leanofis-iot/lora/outdoor-4200/README.txt

SWAP DIGITAL PINNS 3,2 TO 0,1
USE PULLUPS FOR SCL,SDA
DIGITAL PINS TO MOST RIGHT OF CONNECTOR
EDIT ATTACHINTERRUPT
----------------------------------------------------------------------------
HWB 10K GND
CONF CALIBRATE
2MM FULL JUMPER RESISTOR

---------------------------
CONNECTORS
C1,2,3,4,5,6,8
XT1
R2,3,4
LED1
SW1

LoRaWAN Class A/C, EU868MHz
Periodical and Alarm Uplink 
Full Configuration via USB / downlink
Over The Air Activation OTAA
Plug & Play The Things Network, Cayenne

2 Channel Analog Inputs
2 Single / 2 Differential, 0-5V / 0-10V / 4-20ma 
2 Channel Digital Inputs
Logic / Dry Contact / Pulse Counter
Over Voltage, ESD Protection

3.6V Battery, C size,  9Ah, up to 10 years
Managable Power Output 3.3V / 5V 
External Power Input
