leanofis-iot/lora/outdoor-811/Sensör Kullanımı.docx

!!! GATEWAY, ELEKTRİĞE BAĞLAMADAN ÖNCE

ANTENİ TAKILMIŞ OLMALIDIR.

Gateway’e Ehernet Kablosu Bağla

Gateway elektriğe bağla

2 dakika kadar bekle, PWR ve LoRa ledleri sabit yanıyor olacak

Gateway, internete ve TTN’e bağlandı.

Web’de Cayenne konsolu’na git

https://cayenne.mydevices.com/cayenne/dashboard/lora

email: leanofis.iot@gmail.com

password: lean1234

Yukarıda leanofis tıkla

Projedeki tüm cihazlar görüntüleniyor

Sol taraftaki listeden cihazlar ayrı ayrı da görülebilir

th3 cihazına pil tak

Yaylı taraf (-) kutup (ters yerleştirme koruması var)

pil takıldığında ilk göndermeyi yapar

Not:

1. th3 cihaz içindeki mevcut ayarlar;

Gönderme periyodu: 30dk

Sıcaklık düşük alarmı: 10 C

Sıcaklık yüksek alarmı: 40 C

Nem düşük alarmı: 35%

Nem yüksek alarmı: 65%

2. Telefon uygulaması da indirilebilir

Cayenne (myDevices)
