leanofis-iot/lora/outdoor-4200/eagle/ad/BOM.xlsx

IC1 | 1 | ATMEGA32U4-MU | QFN-44
IC2 | 1 | MIC5219YML | TQFN-6
MOD1 | 1 | RAK4200 (H) LORA MODULE | SM-20
Q1,2,3 | 3 | SI2301BDS | SOT23-3
D1,2 | 2 | B5817W (MBR120) | SOD123
D3 | 1 | BZT52C3V9 | SOD123
LED1 | 1 | LED RED | 0805
XT1 | 1 | CRYSTAL PASSIVE 8MHZ 4PIN | 5032
F1 | 1 | PTC RESETTABLE FUSE 0.5A | 1206
SW1 | 1 | PUSH BUTTON 5.2X5.2MM 4P | SM
SW2 | 1 | REED SWITCH <10MM NO | DIP
BAT1 | 1 | 211P-C PCB PIN C SIZE BATTERY HOLDER | DIP
CON1 | 1 | HEADER MALE 2.54MM 6P 2R | DIP
CON2 | 1 | HEADER MALE 2.54MM 10P 2R | DIP
CON3 | 1 | CONNECTOR RF SMA R/A EOCT-WF1320 57001579 | DIP
CON4 | 1 | USB3131 MICRO B USB VERTICAL FEMALE | DIP
CON5 | 1 | HEADER FEMALE 2.54MM 6P 1R | DIP
J1 | 1 | HEADER MALE 2.54MM 2P 1R | DIP
C1,9,13,16 | 4 | 4.7UF | 0603
C2,5,7,8,10,11,12,17,21,22 | 10 | 100NF | 0603
C3,4 | 2 | 22PF | 0603
C6 | 1 | 1UF | 0603
C14,15 | 2 | 10UF | 0805
C18 | 1 | 470PF | 0603
C19,20 | 2 | 1F 2.7V FARAD CAPACITOR 8MM | DIP
R1,3,4,6,8,9,11,13,15,22,23,24,25 | 12 | 10K | 0603
R2,16 | 2 | 1K | 0603
R5,7,10,14 | 3 | 100R | 0603
R12,17 | 2 | 2.2K | 0603
R18,19 | 2 | 22R | 0603
R20
R21
PCB |  | FR4 1.6MM 68x62MM
BATTERY 3.6V 9000MAH C SIZE LISCLO2 |  | ER26500
ANTENNA |  | 868MHZ 8CM SMA-MALE B INNO-868-ZT8BM 57001549
ENCLOSURE IP65 76X70X40MM |  | H-393
SENSOR SHELL/COVER PLASTIC |  | TEMPERATURE & HUMIDITY
