leanofis-iot/lora/outdoor-811/eagle/ad/BOM.xlsx

IC1 | ATMEGA32U4-MU | QFN-44
IC2 | S-5712BNDL2-M3T1U | SOT23-3
IC3 | MIC5219-3.3YML | VQFN-6
IC4 | MCP1640-I/MC | DFN-8
IC5 | ADS1118IRUG | X2QFN-10
IC6 | VREF | SOT23-3
MOD1 | RAK811 | SM-34
Q1,2,3,4 | SI2301 P MOSFET | SOT23-3
D1,2,3 | B5817W | SOD123 | MBR120
D4 | BZT52C3V9 | SOD123
D5,6,7,8,9,10 | BAT54S | SOT23-3
LED1 | LED RED | 0805
XT1 | CRYSTAL PASSIVE 8MHZ 4PIN | 5032
F1 | RESETTABLE FUSE 0.5A | 1206
SW1 | PUSH BUTTON 5X5MM | SM
J1,2,5,6 | HEADER 2.54MM 3P | DIP
J3,4 | HEADER 2.54MM 2P | DIP
ANT1 | CONNECTOR RF SMA R/A EOCT-WF1320 57001579 | DIP
ANT1 | ANTENNA 868MHZ 8CM SMA-MALE B INNO-868-ZT8BM 57001549
CON1 | HEADER 2.54MM 6P 2R | DIP
CON2 | HEADER 2.54MM 10P 2R | DIP
CON3 | CONNECTOR 12P 2.54MM 141V | DIP
CON4 | USB3131 MICRO B USB VERTICAL FEMALE | DIP
L1 | INDUCTOR 4.7UH | 0630
C1,9,13,16,21,30 | 4.7UF | 0603 | C30 ??
C2,5,7,8,10,11,12,17,22,23,25,26,28,29 | 100NF | 0603
C3,4 | 22PF | 0603
C6,24,27 | 1UF | 0603
C14,15,19,20 | 10UF | 0805
C18 | 470PF | 0603
R1,24 | NC | 0603
R2,4,6,8,9,11,27,53 | 10K | 0603
R3,29,30,31 | 1K | 0603
R5,7,14,25,28 | 100R | 0603
R10 | 0R | 0603
R12,17 | 68K | 0603
R13,23 | 100K | 0603
R15,26,45,49,52 | 2.2M | 0603
R16,22 | 27K | 0603
R18,19 | 22R | 0603
R20 | 47K | 0603
R21 | 15K | 0603
R32,38 | 2.2K | 0805
R34,36,40,42 | 2.2M | 0805
R37,43 | 500R | 0805
R33,35,39,41,46,47,50,51 | 10K | 0805
R44,48 | 1K | 0805
PCB
BATTERY
BATTERY HOLDER C SIZE | BH-211-1A
CHINA BATTERY HOLDER
BOX
CABLE GLAND
TH SHELL
