leanofis-iot/lora/rtu/arduino/rtu past3/eagle/BOM.xlsx

IC1 | 1 | ATMEGA32U4-MU | QFN-44
IC2 | 1 | AP63200WU-7 | SOT23-6
IC3 | 1 | DS3231M | SOIC-8 | link (http://www.aliexpress.com/item/32842116667.html?spm=a2g0o.productlist.0.0.207e5425iMi2qF)
IC4,5 | 2 | HCPL-181-00BE (PC357N) | SM MINI FLAT | link (https://www.aliexpress.com/item/32909119073.html?spm=2114.12010615.8148356.4.657bf361XrP6RL)
IC6,7 | 2 | INA226AIDGS | VSSOP-10 | link (http://www.aliexpress.com/item/33021667752.html?spm=2114.12010615.8148356.2.31ef2adf4GEmzi)
IC8 | 1 | ISL3172EIBZ | SOIC-8 | link (https://www.aliexpress.com/item/4000185507133.html?spm=2114.12010615.8148356.1.508c33460t39pk)
IC9,10 | 2 | NUD3124DMT1G | SC74-6 | link (https://www.aliexpress.com/item/32968598412.html?spm=2114.12010615.8148356.1.2f9a547akpF4q6)
MOD1 | 1 | RAK4200 LORA MODULE EU868MHZ | SM-20 | link (https://store.rakwireless.com/products/rak4200-lora-module?variant=31767678091309)
D1,2 | 2 | B5817W | SOD123 | REFERENCE
D3 | 1 | BZT52C3V9 | SOD123 | REFERENCE
LED1 | 1 | LED LAMP HOLDER BLOCK RED GREEN | DIP | link (https://www.aliexpress.com/item/32599385323.html)
XT1 | 1 | CRYSTAL PASSIVE 8MHZ 4PIN | 5032 | link (https://www.aliexpress.com/item/33010692278.html?spm=2114.12010615.8148356.8.e30c5802x90R2k)
F1 | 1 | PTC RESETTABLE FUSE 0.5A | 1206 | link (https://www.aliexpress.com/item/32876140005.html?spm=2114.12010615.8148356.3.5236158aukLNWK)
F2,3 | 2 | PTC RESETTABLE FUSE 0.05A | 1206 | link (https://www.aliexpress.com/item/32876140005.html?spm=2114.12010615.8148356.3.5236158aukLNWK)
SW1,2 | 2 | PUSH BUTTON TACTILE SWITCH 6X6X9MM R/A | DIP | link (https://www.aliexpress.com/item/32901481925.html)
SW3,4 | 2 | HFD2-003-M-L2 3VDC BISTABLE/LATCH 2 COIL RELAY | DIP | link (https://www.aliexpress.com/item/4000554934263.html?spm=2114.12010615.8148356.4.712c6ca21gaZmO)
BAT1 | 1 | CR1220 BATTERY HOLDER INSERT 15MM ( BS-1220 ) (BC501SM) (S8411-45R) | SM | link (https://www.aliexpress.com/item/32971589644.html?spm=2114.12010615.8148356.6.6289344daPmFSS)
(BATTERY) | 1 | CR1220 3V LITHIUM COIN | COIN
CON1 | 1 | HEADER MALE 2.54MM 6P 2R | DIP
CON2 | 1 | HEADER MALE 2.54MM 8P 2R | DIP
CON3 | 1 | CONNECTOR RF SMA R/A EOCT-WF1320 57001579 | DIP | link (https://www.aliexpress.com/item/33050835786.html)
CON4 | 1 | STANDARD MICRO B USB FEMALE CONNECTOR | SM | link (https://www.aliexpress.com/item/32847817922.html)
CON5 | 1 | KF2EDGR-3.5-12P (HEADER) + KF2EDGK-3.5-12P (PLUG) | DIP
CON6 | 1 | KF2EDGR-3.5-6P (HEADER) + KF2EDGK-3.5-12P (PLUG) | DIP
L1 | 1 | CDRH74R 6.8UH INDUCTOR 7.3X7.3X4MM SHIELDED | SM | 0630 SIZE SHIELDED REFERENCE
L2,3 | 2 | MMZ2012Y152B FERRITE BEAD | 0805 | (150R @100MHZ) REFERENCE
C1,9,16,19,24,27,30 | 7 | 4.7UF X5R/X7R | 0603
C2,5,7,8,12,15,17,18,20,21,22,23,25,28,31,33 | 16 | 100NF X5R/X7R | 0603
C3,4 | 2 | 22PF X5R/X7R | 0603
C6,26,29 | 3 | 1UF X5R/X7R | 0603
C10,13,14 | 3 | 22UF X7R | 1206
C11 | 1 | 100PF X5R/X7R | 0603
C32 | 1 | 100UF 8MM | SM
R1,2 | 2 | 22R 5% | 0603
R3,4,10,12,14,18,19,20,22,24,25,30,35,37,40,43 | 16 | 10K 5% | 0603
R5,6 | 2 | 220R 5% | 0603
R7 | 1 | 115K 1% | 0603
R8 | 1 | 33K 1% | 0603
R9,11,13,36,38,39 | 6 | 100R 5% | 0603
R15,16,17 | 3 | 1K 5% | 0603
R21,23 | 2 | 2K2 5% | 0805
R26,28,31,33 | 4 | 10R 1% | 0603
R27,32 | 2 | 3.3R 1% | 1206
R29,34 | 2 | 10R 5% | 0603
R41,42 | 2 | 10R 1% | 0805
ANTENNA | 1 | 868MHZ 5DBI SMA-MALE WHIP |  | link (https://www.aliexpress.com/item/32920533464.html?spm=2114.12010612.8148356.1.39749e87FQTW8I)
ALUMINUM ENCLOSURE | 1 | AK-C-A4 28(H)X66(L)X104(W) MM COLOR BLUE |  | angie@szomk.com.cn
PCB | 1 | FR4 1.6MM 1ozCu 76.2X65.4MM (3000X2575MIL) BLUE MASK
