leanofis-iot/lora/outdoor-811/LoRa Sensor Test.docx

!!! GATEWAY VE SENSÖR CİHAZI

ANTENLERİ TAKILMIŞ OLMALIDIR.

Başlamadan bana mesaj atın lütfen..

Gateway’e Ehernet Kablosu bağlayıp adaptörü elektriğe takın.

2 dakika bekleyin, PWR ve LoRa ledleri sabit yanıyor olacak

Gateway, internete bağlandı.

Telefon Browser’da The Things Network (TTN) konsol adresine gidin.

https://console.thethingsnetwork.org/gateways/eui-60c5a8fffe74d32b/traffic

email: leanofis.iot@gmail.com

password: lean1234

Cihaz Gateway’in yakınında iken Pilini takın

Yaylı taraf (-) kutup (ters yerleştirme koruması var)

Led yanıp sönmelerinin tamamlanmasını bekleyin

Cihaz TTN’e kendiliğinden birkaç deneme yaparak bağlanır ve ilk defa veri gönderir.

(Mavi ok işareti ile başlayan satır gönderim kaydıdır)

İstenen mesafelerde Buton’a basıp bırakarak gönderme testi yapabilirsiniz.

Led sönmeden tekrar basmayın.
