leanofis-iot/lora/rtu/arduino/rtu past3/eagle/rtu.brd

## EAGLE design rtu/arduino/rtu past3/eagle/rtu.brd (2020-01-22)

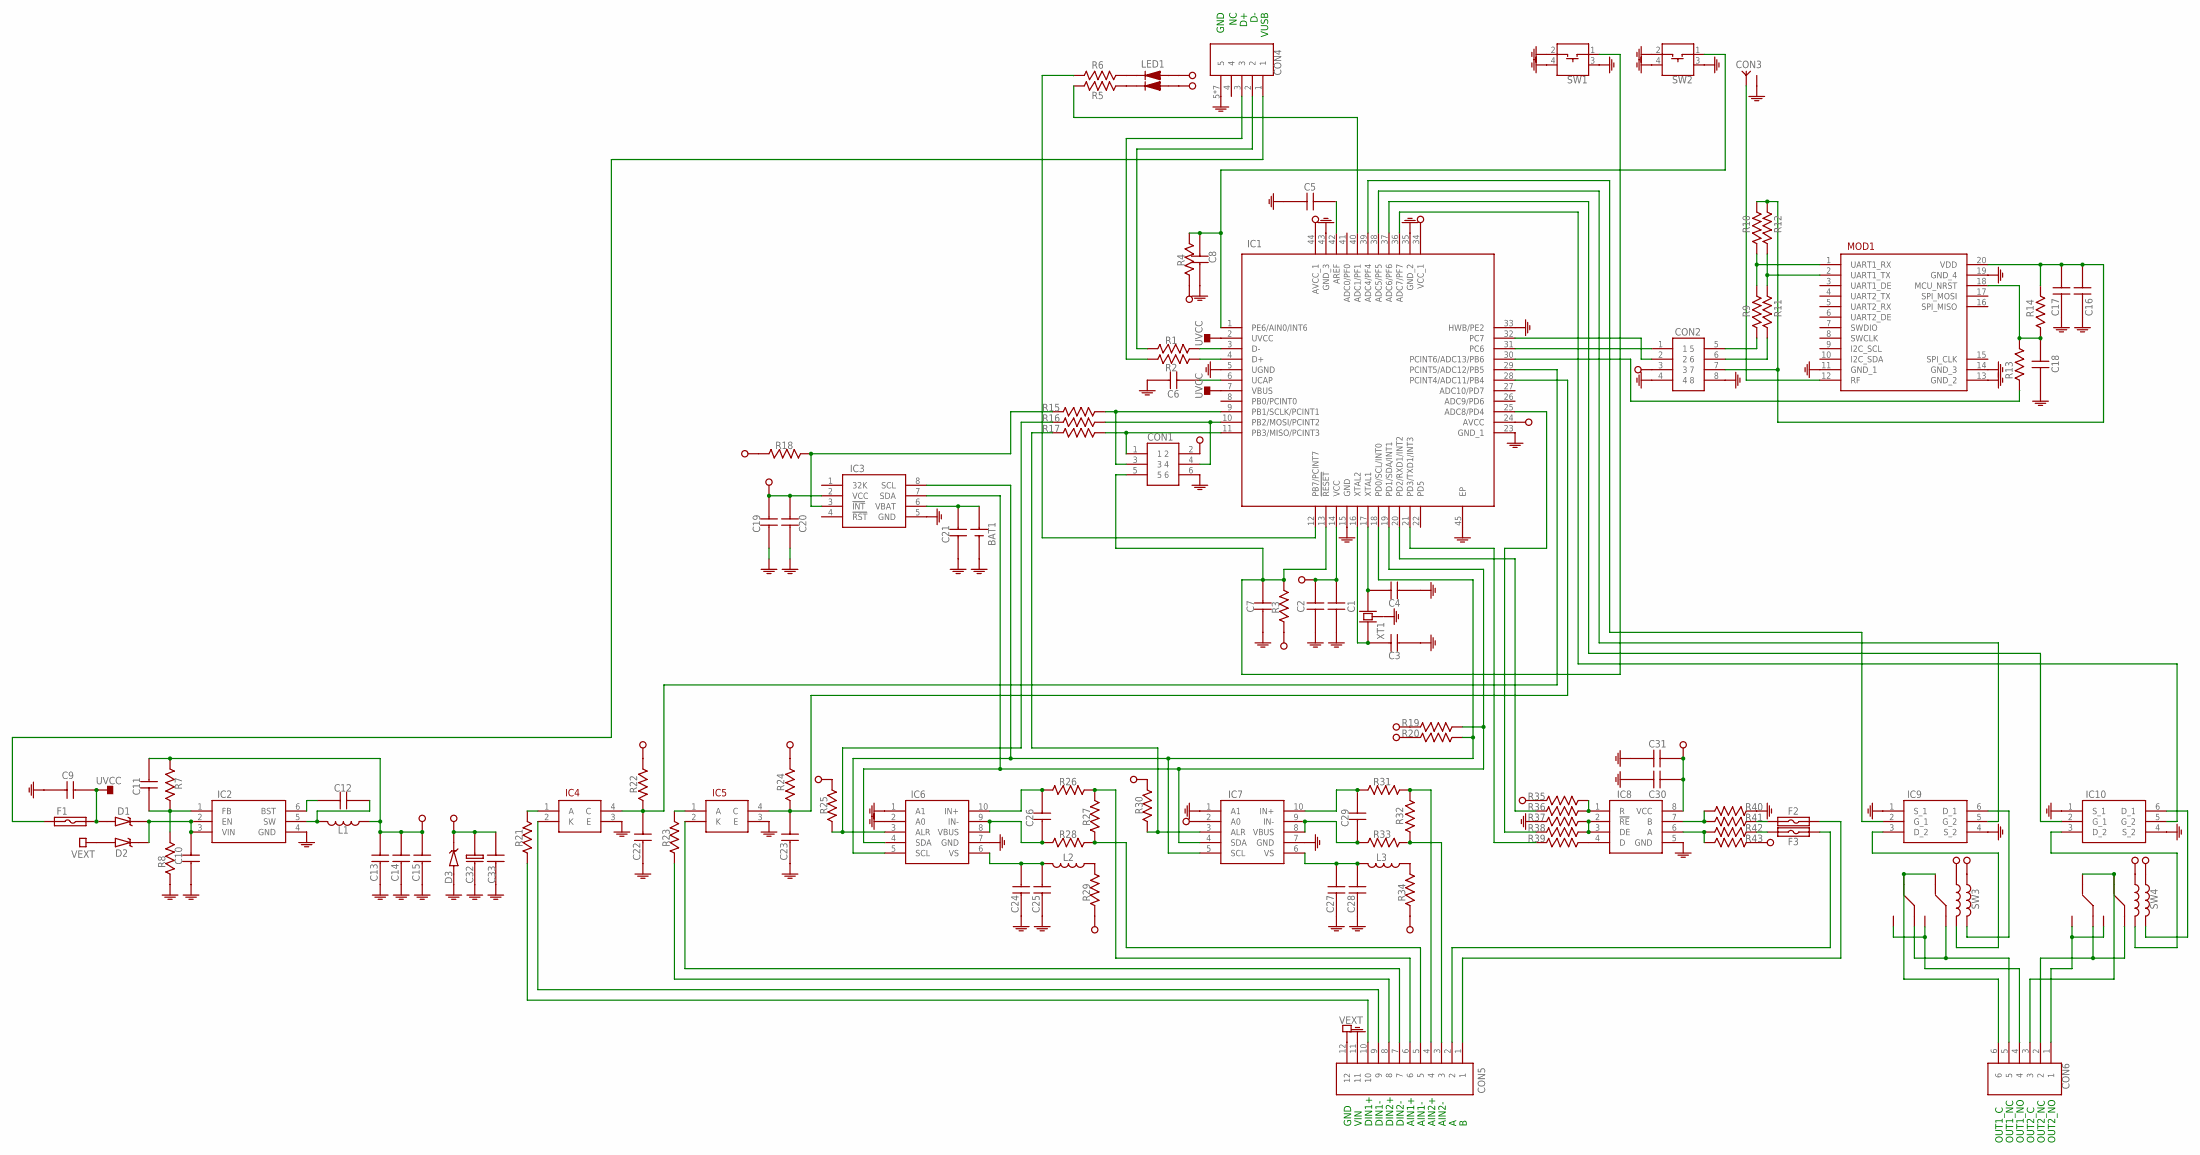
[picture p3: schematic rtu.sch]

Parts:
BAT1: BAT-1220-BC501SM
C1, C2, C3, C4, C5, C6, C7, C8, C9, C11, C12, C15, C16, C17, C18, C19, C20, C21, C22, C23, C24, C25, C26, C27, C28, C29, C30, C31, C33: CAPACITOR-0603; 0603
C10, C13, C14: CAPACITOR-1206; 1206
C32: CAPACITOR-SMD-8
CON1: ISP
CON2: HEADER-8P-2R-DIP-2_54MM
CON3: SMA-RF
CON4: USB-MICRO-B-SMD
CON5: KF2EDGR-3.5-12P
CON6: KF2EDGR-3.5-6P
D1, D2: DIODE-SCHOTTKY; SOD123-DIODE
D3: ZENER-SOD123; SOD123-DIODE
F1, F2, F3: FUSE-1206; 1206
IC1: ATMEGA32U4-MU; QFN-44
IC2: AP63200; SOT23-6
IC3: DS3231M; SOIC-8
IC4, IC5: OPTO-SMD
IC6, IC7: INA226; VSSOP-10
IC8: IC-485-HALF; SOIC-8
IC9, IC10: NUD3105-12-24-60; SC74-6
L1: INDUCTOR-0520-0630
L2, L3: INDUCTOR-0805; 0805
LED1: LED-HOLDER-2P
MOD1: RAK4200
R1, R2, R3, R4, R5, R6, R7, R8, R9, R10, R11, R12, R13, R14, R15, R16, R17, R18, R19, R20, R22, R24, R25, R26, R28, R29, R30, R31, R33, R34, R35, R36, R37, R38, R39, R40, R43: RESISTOR-0603; 0603
R21, R23, R41, R42: RESISTOR-0805; 0805
R27, R32: RESISTOR-1206; 1206
SW1, SW2: B3F-3150-52-55
SW3, SW4: HFD2-L2
XT1: CRYSTAL-5032-4P

Connections:
GND: BAT1.-, C1.1, C2.1, C3.1, C4.1, C5.1, C6.1, C7.1, C8.2, C9.1, C10.1, C13.1, C14.1, C15.1, C16.1, C17.1, C18.1, C19.1, C20.1, C21.1, C22.1, C23.1, C24.1, C25.1, C27.1, C28.1, C30.1, C31.1, C32.1, C33.1, CON1.6, CON2.4, CON2.8, CON3.2 (GND), CON3.3 (GND), CON3.4 (GND), CON3.5 (GND), CON4.5, CON4.6 (5), CON4.7 (5), CON4.8 (5), CON4.9 (5), CON4.10 (5), CON4.11 (5), CON5.11, D3.2 (A), IC1.5 (UGND), IC1.15 (GND), IC1.23 (GND_1), IC1.33 (HWB/PE2), IC1.35 (GND_2), IC1.43 (GND_3), IC1.45 (EP), IC2.4 (GND), IC3.5 (GND), IC4.3 (E), IC5.3 (E), IC6.1 (A1), IC6.2 (A0), IC6.7 (GND), IC7.1 (A1), IC7.7 (GND), IC8.5 (GND), IC9.1 (S_1), IC9.4 (S_2), IC10.1 (S_1), IC10.4 (S_2), MOD1.11 (GND_1), MOD1.13 (GND_2), MOD1.14 (GND_3), MOD1.19 (GND_4), R8.1, R37.1, R40.1, SW1.2, SW1.3, SW1.4, SW2.2, SW2.3, SW2.4, XT1.2 (GND), XT1.4 (GND)
unnamed: IC1.40 (ADC1/PF1), R5.1
unnamed: C18.2, MOD1.18 (MCU_NRST), R13.1, R14.1
unnamed: CON1.1, IC1.11 (PB3/MISO/PCINT3), R17.2
unnamed: CON3.1 (ANT), MOD1.12 (RF)
unnamed: CON2.2, IC1.32 (PC7)
unnamed: MOD1.1 (UART1_RX), R9.2, R10.1
unnamed: MOD1.2 (UART1_TX), R11.2, R12.1
unnamed: LED1.1 (K1), R6.2
unnamed: CON1.4, IC1.10 (PB2/MOSI/PCINT2), R16.2
unnamed: C3.2, IC1.16 (XTAL2), XT1.1
unnamed: CON2.1, IC1.31 (PC6)
unnamed: C4.2, IC1.17 (XTAL1), XT1.3 (2)
unnamed: C16.2, C17.2, CON2.7, MOD1.20 (VDD), R10.2, R12.2, R14.2
unnamed: CON2.5, R9.1
unnamed: LED1.3 (K2), R5.2
unnamed: CON2.6, R11.1
unnamed: C29.1, IC7.8 (VBUS), IC7.9 (IN-), R33.2
unnamed: CON4.2, R1.1
unnamed: CON4.3, R2.1
unnamed: IC4.1 (A), R21.2
unnamed: C29.2, IC7.10 (IN+), R31.2
unnamed: IC1.30 (PCINT6/ADC13/PB6), R13.2
unnamed: IC6.3 (ALR), R16.1, R25.2
unnamed: IC1.36 (ADC7/PF7), IC10.5 (G_2)
unnamed: IC7.3 (ALR), R17.1, R30.2
unnamed: IC9.6 (D_1), SW3.L1-
unnamed: L3.1, R34.2
unnamed: IC9.3 (D_2), SW3.L2-
unnamed: C8.1, IC1.1 (PE6/AIN0/INT6), R4.1, SW2.1
unnamed: CON5.4, R31.1, R32.1
unnamed: C5.2, IC1.42 (AREF)
unnamed: C23.2, IC1.28 (PCINT4/ADC11/PB4), IC5.4 (C), R24.2
unnamed: IC5.1 (A), R23.2
unnamed: C6.2, IC1.6 (UCAP)
unnamed: C22.2, IC1.29 (PCINT5/ADC12/PB5), IC4.4 (C), R22.2
unnamed: IC1.12 (PB7/PCINT7), R6.1
unnamed: IC1.37 (ADC6/PF6), IC10.2 (G_1)
unnamed: CON6.1, SW4.NO1, SW4.NO2
unnamed: CON5.3, R32.2, R33.1
unnamed: C7.2, CON1.5, IC1.13 (!RESET), R3.2, SW1.1
unnamed: C27.2, C28.2, IC7.6 (VS), L3.2
unnamed: IC1.3 (D-), R1.2
unnamed: IC1.4 (D+), R2.2
unnamed: CON1.3, IC1.9 (PB1/SCLK/PCINT1), R15.2
unnamed: CON5.2, F3.1
unnamed: IC8.1 (R), R35.2, R36.2
unnamed: IC8.4 (D), R39.2
unnamed: CON5.7, IC5.2 (K)
unnamed: CON5.9, IC4.2 (K)
unnamed: IC8.7 (B), R40.2, R41.2
unnamed: IC8.6 (A), R42.2, R43.2
unnamed: IC8.2 (!RE), IC8.3 (DE), R37.2, R38.2
unnamed: F3.2, R42.1
unnamed: CON5.8, R23.1
unnamed: CON4.1, F1.1
unnamed: C10.2, D1.1 (K), D2.1 (K), IC2.2 (EN), IC2.3 (VIN)
unnamed: BAT1.+, C21.2, IC3.6 (VBAT)
unnamed: CON5.6, R26.2, R27.2
unnamed: CON5.1, F2.1
unnamed: IC1.20 (PD2/RXD1/INT2), R36.1
unnamed: IC1.21 (PD3/TXD1/INT3), R39.1
unnamed: IC1.25 (ADC8/PD4), R38.1
unnamed: IC10.6 (D_1), SW4.L1-
unnamed: C12.2, IC2.6 (BST)
unnamed: C12.1, IC2.5 (SW), L1.2
unnamed: CON6.2, SW4.NC1, SW4.NC2
unnamed: C26.2, IC6.10 (IN+), R26.1
unnamed: C26.1, IC6.8 (VBUS), IC6.9 (IN-), R28.1
unnamed: IC3.3 (!INT), R15.1, R18.2
unnamed: L2.1, R29.2
unnamed: C11.1, IC2.1 (FB), R7.2, R8.2
unnamed: IC1.18 (PD0/SCL/INT0), IC3.8 (SCL), IC6.5 (SCL), IC7.5 (SCL), R20.2
unnamed: CON6.3, SW4.C1, SW4.C2
unnamed: C24.2, C25.2, IC6.6 (VS), L2.2
unnamed: IC1.19 (PD1/SDA/INT1), IC3.7 (SDA), IC6.4 (SDA), IC7.4 (SDA), R19.2
unnamed: F2.2, R41.1
unnamed: CON5.5, R27.1, R28.2
unnamed: IC10.3 (D_2), SW4.L2-
unnamed: CON5.10, R21.1
unnamed: CON6.4, SW3.NO1, SW3.NO2
unnamed: CON6.5, SW3.NC1, SW3.NC2
unnamed: CON6.6, SW3.C1, SW3.C2
unnamed: IC1.38 (ADC5/PF5), IC9.5 (G_2)
unnamed: IC1.39 (ADC4/PF4), IC9.2 (G_1)
UVCC: C9.2, D1.2 (A), F1.2, IC1.2 (UVCC), IC1.7 (VBUS)
VCC: C1.2, C2.2, C11.2, C13.2, C14.2, C15.2, C19.2, C20.2, C30.2, C31.2, C32.2, C33.2, CON1.2, CON2.3, D3.1 (K), IC1.14 (VCC), IC1.24 (AVCC), IC1.34 (VCC_1), IC1.44 (AVCC_1), IC3.2 (VCC), IC7.2 (A0), IC8.8 (VCC), L1.1, LED1.2 (A1), LED1.4 (A2), R3.1, R4.2, R7.1, R18.1, R19.1, R20.1, R22.1, R24.1, R25.1, R29.1, R30.1, R34.1, R35.1, R43.1, SW3.L1+, SW3.L2+, SW4.L1+, SW4.L2+
VEXT: CON5.12, D2.2 (A)

Notes on the sheet:
VIN
GND
AIN1+
AIN1-
AIN2+
AIN2-
DIN1+
DIN1-
DIN2+
DIN2-
OUT1_C
OUT1_NC
OUT1_NO
OUT2_NC
OUT2_C
OUT2_NO
VUSB

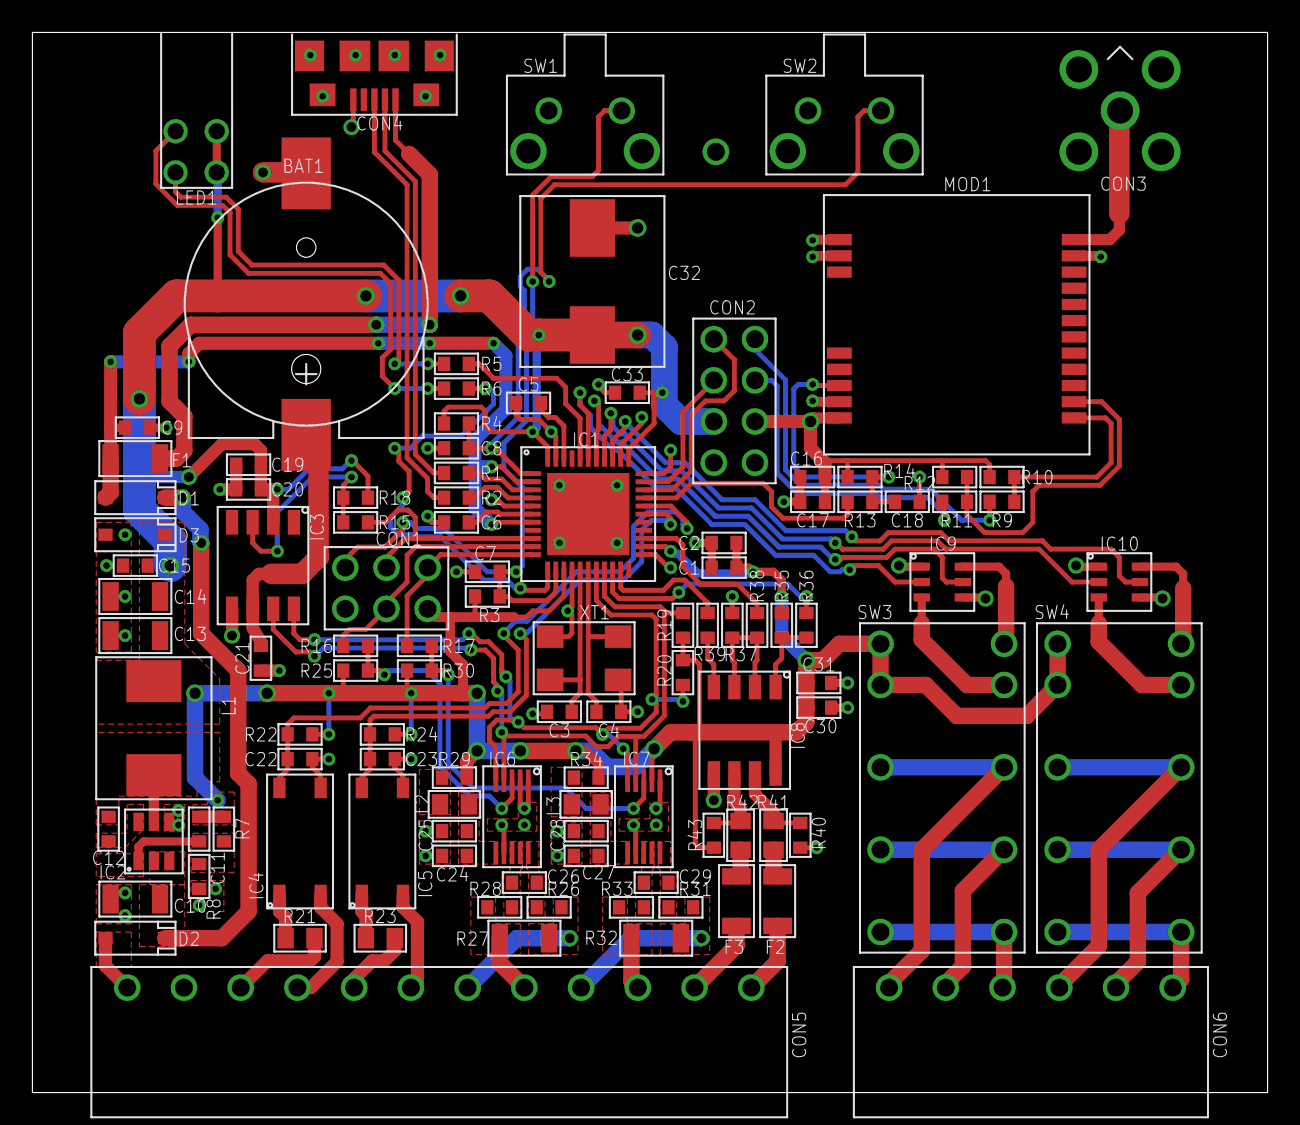
[picture p4: board rtu.brd from above]

Board: 2 copper layers, 76.2 x 65.4 mm, 109 parts (0 on the bottom side), 88 nets.
