leanofis-iot/lora/outdoor-4200/eagle/sht/sht.brd

## EAGLE design outdoor-4200/eagle/sht/sht.brd (2019-12-27)

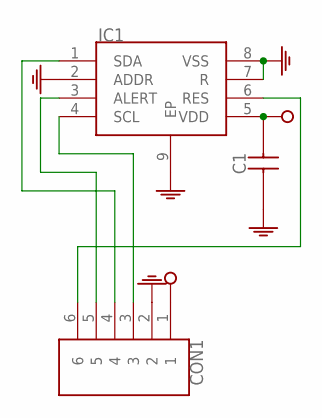
[picture p8: schematic sht.sch]

Parts:
C1: CAPACITOR-0603; 0603
CON1: HEADER-6P-DIP-2_54MM
IC1: SHT3X-DIS

Connections:
GND: C1.1, CON1.2, IC1.2 (ADDR), IC1.7 (R), IC1.8 (VSS), IC1.9 (EP)
unnamed: CON1.6, IC1.6 (RES)
unnamed: CON1.4, IC1.1 (SDA)
unnamed: CON1.3, IC1.4 (SCL)
unnamed: CON1.5, IC1.3 (ALERT)
VCC: C1.2, CON1.1, IC1.5 (VDD)

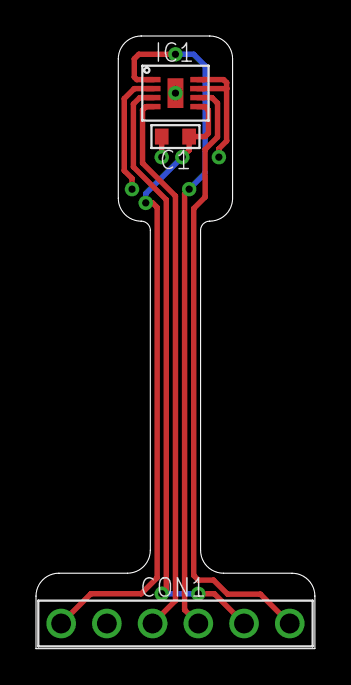
[picture p9: board outdoor-4200/eagle/sht/sht.brd from above]

Board: 2 copper layers, 15.5 x 34.0 mm, 3 parts (0 on the bottom side), 6 nets.
