leanofis-iot/lora/outdoor-811/eagle/ad/ad.brd

## EAGLE design outdoor-811/eagle/ad/ad.brd (2019-12-27)

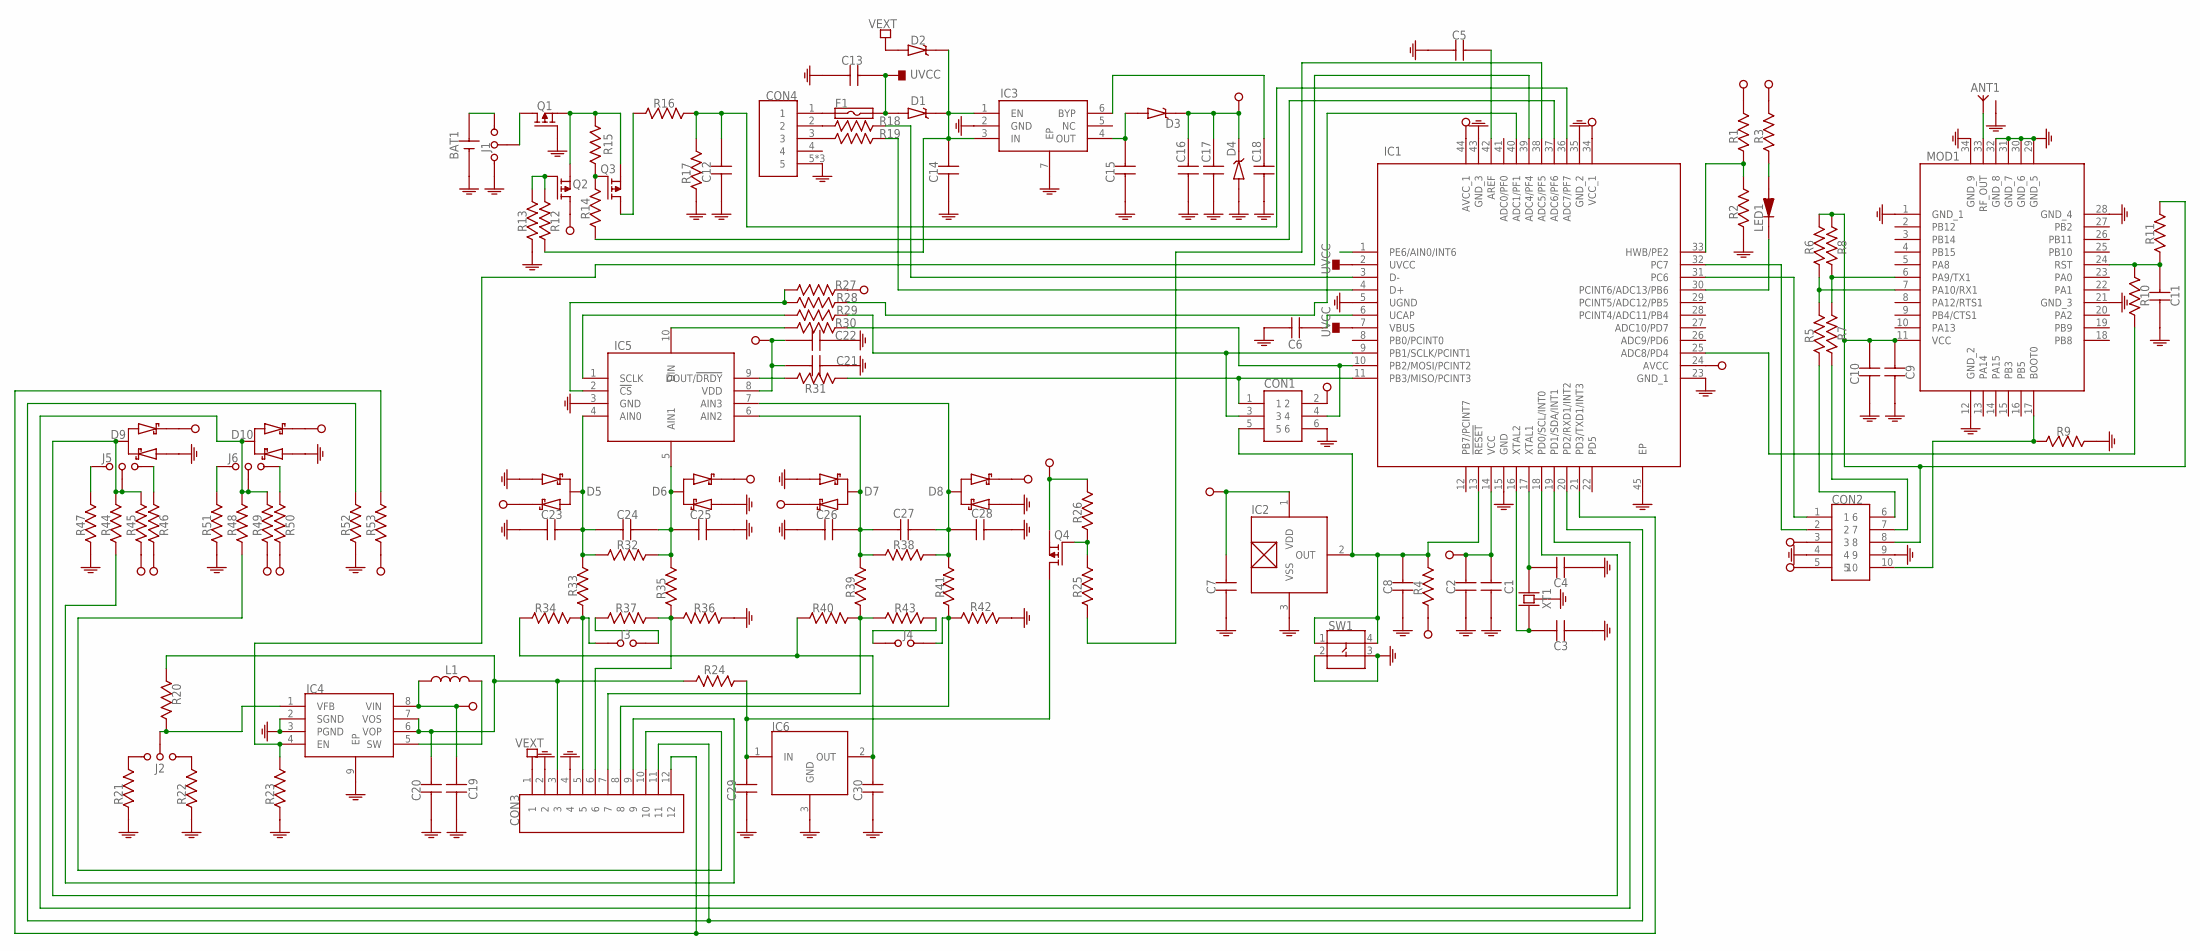
[picture p10: schematic ad.sch]

Parts:
ANT1: SMA-RF
BAT1: 211P-C-HOLDER
C1, C2, C3, C4, C5, C6, C7, C8, C9, C10, C11, C12, C13, C16, C17, C18, C21, C22, C23, C24, C25, C26, C27, C28, C29, C30: CAPACITOR-0603; 0603
C14, C15, C19, C20: CAPACITOR-0805; 0805
CON1: ISP
CON2: HEADER-10P-2R-DIP-2_54MM
CON3: CON-12P-2_54MM-141V
CON4: USB-MICRO-DIP-VER
D1, D2, D3: DIODE-SCHOTTKY; SOD123-DIODE
D4: ZENER-SOD123; SOD123-DIODE
D5, D6, D7, D8, D9, D10: SCHOTTKY-SERIE-3P; SOT23-3
F1: FUSE-1206; 1206
IC1: ATMEGA32U4-MU; QFN-44
IC2: S-5712-SOT23-3; SOT23-3
IC3: MIC5219-VDFN-6; VDFN-6
IC4: MCP1640-DFN-8; DFN-8-2X3
IC5: ADS1118IRUGT; X2QFN-10
IC6: VREF-SOT23-3; SOT23-3
J1, J2, J5, J6: JUMPER-3P; HEADER-3P-DIP-2_54MM
J3, J4: JUMPER; HEADER-2P-DIP-2_54MM
L1: INDUCTOR-0520-0630
LED1: LED-0805
MOD1: RAK811
Q1, Q2, Q3, Q4: P-MOSFET; SOT23-3
R1, R2, R3, R4, R5, R6, R7, R8, R9, R10, R11, R12, R13, R14, R15, R16, R17, R18, R19, R20, R21, R22, R23, R24, R25, R26, R27, R28, R29, R30, R31, R45, R49, R52, R53: RESISTOR-0603; 0603
R32, R33, R34, R35, R36, R37, R38, R39, R40, R41, R42, R43, R44, R46, R47, R48, R50, R51: RESISTOR-0805; 0805
SW1: BUTTON-4P-SMD-5X5
XT1: CRYSTAL-5032-4P

Connections:
GND: ANT1.2 (GND), ANT1.3 (GND), ANT1.4 (GND), ANT1.5 (GND), BAT1.2 (-), C1.1, C2.1, C3.1, C4.1, C5.1, C6.1, C7.1, C8.1, C9.1, C10.1, C11.1, C12.1, C13.1, C14.1, C15.1, C16.1, C17.1, C18.1, C19.1, C20.1, C21.1, C22.2, C23.1, C25.2, C26.1, C28.1, C29.1, C30.1, CON1.6, CON2.4, CON2.9, CON3.2, CON3.4, CON4.5, CON4.6 (5), CON4.7 (5), D4.2 (A), D5.1, D6.1, D7.1, D8.1, D9.1, D10.1, IC1.5 (UGND), IC1.15 (GND), IC1.23 (GND_1), IC1.35 (GND_2), IC1.43 (GND_3), IC1.45 (EP), IC2.3 (VSS), IC3.2 (GND), IC3.7 (EP), IC4.2 (SGND), IC4.3 (PGND), IC4.9 (EP), IC5.3 (GND), IC6.3 (GND), J1.1, MOD1.1 (GND_1), MOD1.12 (GND_2), MOD1.21 (GND_3), MOD1.28 (GND_4), MOD1.29 (GND_5), MOD1.30 (GND_6), MOD1.31 (GND_7), MOD1.32 (GND_8), MOD1.34 (GND_9), Q1.1 (G), R2.1, R9.2, R13.1, R17.1, R21.1, R22.1, R23.1, R36.1, R42.1, R47.1, R51.1, R52.1, SW1.2, SW1.3, XT1.2 (GND), XT1.4 (GND)
unnamed: IC5.1 (SCLK), R29.2
unnamed: C11.2, MOD1.24 (RST), R10.1, R11.1
unnamed: CON1.1, IC1.11 (PB3/MISO/PCINT3), R31.2
unnamed: ANT1.1 (ANT), MOD1.33 (RF_OUT)
unnamed: CON3.5, J3.1, R33.1, R34.2
unnamed: MOD1.7 (PA10/RX1), R5.2, R6.1
unnamed: MOD1.6 (PA9/TX1), R7.2, R8.1
unnamed: IC5.2 (!CS), R27.1, R28.2
unnamed: CON1.4, IC1.10 (PB2/MOSI/PCINT2), R30.2
unnamed: C3.2, IC1.16 (XTAL2), XT1.1
unnamed: CON2.1, IC1.31 (PC6)
unnamed: C4.2, IC1.17 (XTAL1), XT1.3 (2)
unnamed: C9.2, C10.2, CON2.8, MOD1.11 (VCC), R6.2, R8.2, R11.2
unnamed: CON2.7, R7.1
unnamed: C20.2, CON3.3, IC4.6 (VOP), IC4.7 (VOS), R20.1, R24.2
unnamed: IC1.25 (ADC8/PD4), R10.2
unnamed: IC5.10 (DIN), R30.1
unnamed: IC5.9 (DOUT/!DRDY), R31.1
unnamed: IC1.30 (PCINT6/ADC13/PB6), LED1.1 (K)
unnamed: CON3.7, R39.1, R40.2, R43.2
unnamed: CON3.6, R35.1, R36.2, R37.2
unnamed: IC4.1 (VFB), J2.2, R20.2
unnamed: C24.2, C25.1, D6.3, IC5.5 (AIN1), R32.2, R35.2
unnamed: C23.2, C24.1, D5.3, IC5.4 (AIN0), R32.1, R33.2
unnamed: CON3.8, J4.1, R41.1, R42.2
unnamed: C26.2, C27.2, D7.3, IC5.6 (AIN2), R38.2, R39.2
unnamed: IC1.40 (ADC1/PF1), R28.1
unnamed: C29.2, IC6.1 (IN), Q4.3 (D), R24.1
unnamed: CON2.2, IC1.32 (PC7)
unnamed: C27.1, C28.2, D8.3, IC5.7 (AIN3), R38.1, R41.2
unnamed: C5.2, IC1.42 (AREF)
unnamed: Q3.1 (G), R14.2, R15.2
unnamed: CON4.1, F1.1
unnamed: C6.2, IC1.6 (UCAP)
unnamed: LED1.2 (A), R3.1
unnamed: C12.2, IC1.36 (ADC7/PF7), R16.2, R17.2
unnamed: C18.2, IC3.6 (BYP)
unnamed: C14.2, D1.1 (K), D2.1 (K), IC3.1 (EN), IC3.3 (IN), R12.1
unnamed: J2.1, R22.2
unnamed: C15.2, D3.2 (A), IC3.4 (OUT)
unnamed: CON4.2, R18.1
unnamed: CON4.3, R19.1
unnamed: IC1.3 (D-), R18.2
unnamed: IC1.4 (D+), R19.2
unnamed: CON1.3, IC1.9 (PB1/SCLK/PCINT1), R29.1
unnamed: Q4.1 (G), R25.2, R26.1
unnamed: IC1.37 (ADC6/PF6), R14.1
unnamed: J1.2, Q1.3 (D)
unnamed: J2.3, R21.2
unnamed: IC1.38 (ADC5/PF5), R25.1
unnamed: BAT1.1 (+), J1.3
unnamed: D9.3, IC1.18 (PD0/SCL/INT0), J5.2, R44.2, R45.2
unnamed: Q2.1 (G), R12.2, R13.2
unnamed: D10.3, IC1.19 (PD1/SDA/INT1), J6.2, R48.2, R49.2
unnamed: CON3.12, IC1.21 (PD3/TXD1/INT3), R53.2
unnamed: C30.2, IC6.2 (OUT), R34.1, R40.1
unnamed: Q1.2 (S), Q2.2 (S), Q3.2 (S), R15.1
unnamed: Q3.3 (D), R16.1
unnamed: CON2.6, R5.1
unnamed: IC1.33 (HWB/PE2), R1.1, R2.2
unnamed: CON2.10, MOD1.17 (BOOT0), R9.1
unnamed: C8.2, CON1.5, IC1.13 (!RESET), IC2.2 (OUT), R4.2, SW1.1, SW1.4
unnamed: IC4.5 (SW), L1.2
unnamed: IC1.39 (ADC4/PF4), IC4.4 (EN), R23.2
unnamed: CON3.11, IC1.20 (PD2/RXD1/INT2), R52.2
unnamed: J4.2 (3), R43.1
unnamed: CON3.10, R48.1
unnamed: J3.2 (3), R37.1
unnamed: CON3.9, R44.1
unnamed: J6.1, R51.2
unnamed: J6.3, R50.2
unnamed: J5.1, R47.2
unnamed: J5.3, R46.2
UVCC: C13.2, D1.2 (A), F1.2, IC1.2 (UVCC), IC1.7 (VBUS)
VCC: C1.2, C2.2, C7.2, C16.2, C17.2, C19.2, C21.2, C22.1, CON1.2, CON2.3, CON2.5, D3.1 (K), D4.1 (K), D5.2, D6.2, D7.2, D8.2, D9.2, D10.2, IC1.14 (VCC), IC1.24 (AVCC), IC1.34 (VCC_1), IC1.44 (AVCC_1), IC2.1 (VDD), IC4.8 (VIN), IC5.8 (VDD), L1.1, Q2.3 (D), Q4.2 (S), R1.2, R3.2, R4.1, R26.2, R27.2, R45.1, R46.1, R49.1, R50.1, R53.1
VEXT: CON3.1, D2.2 (A)

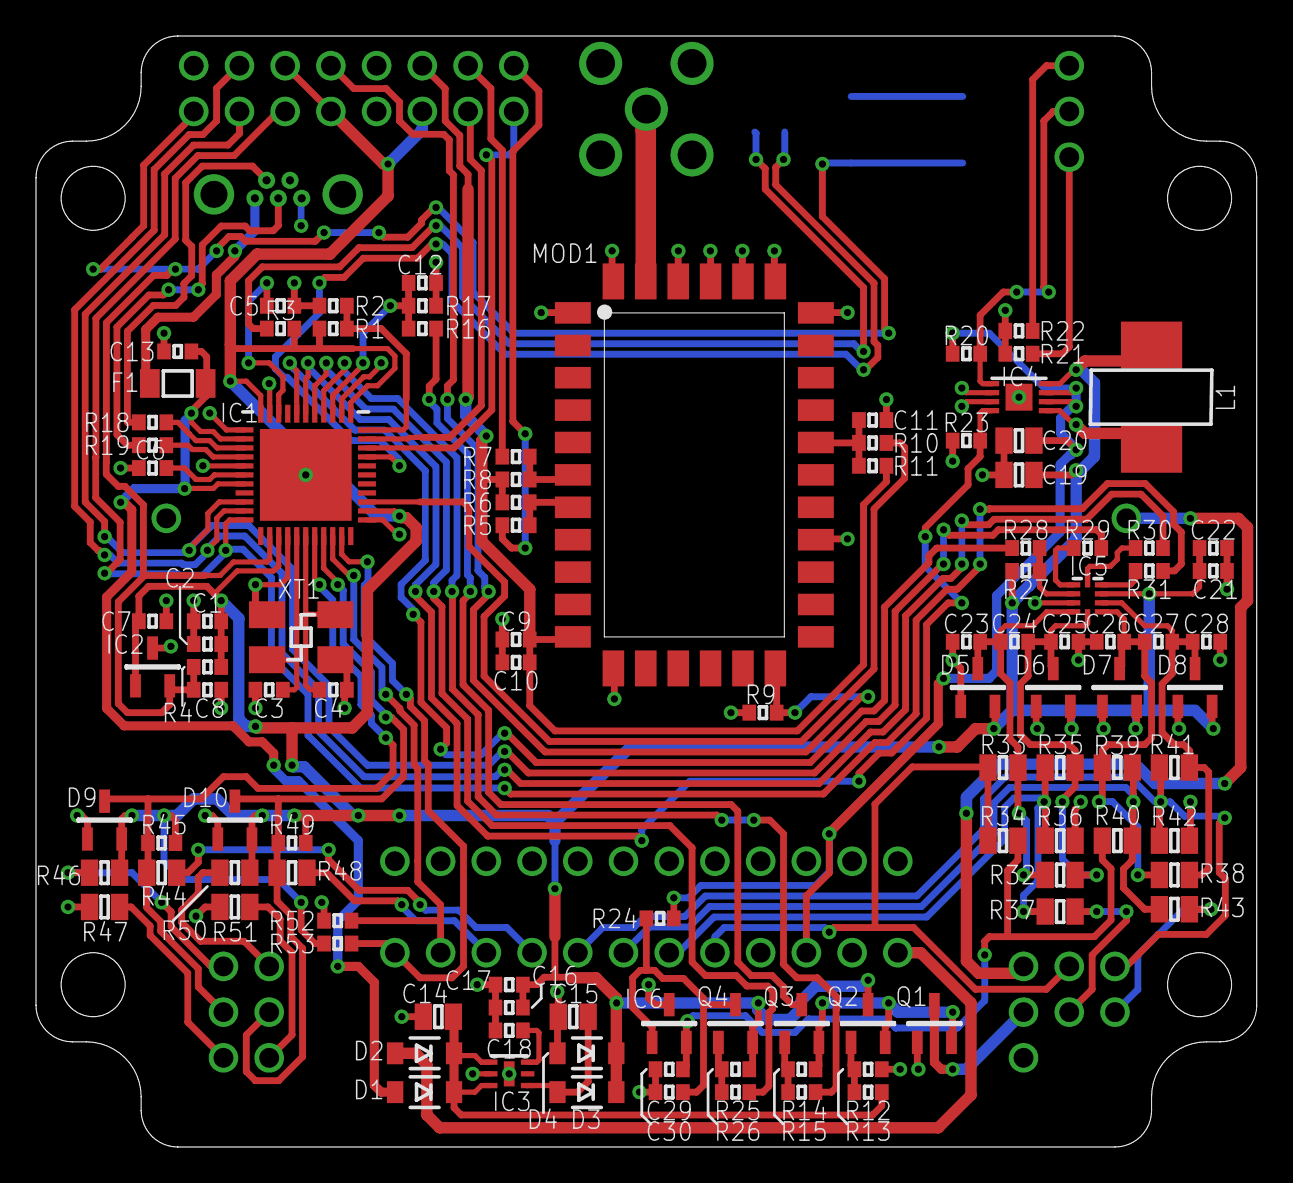
[picture p11: board outdoor-811/eagle/ad/ad.brd from above]

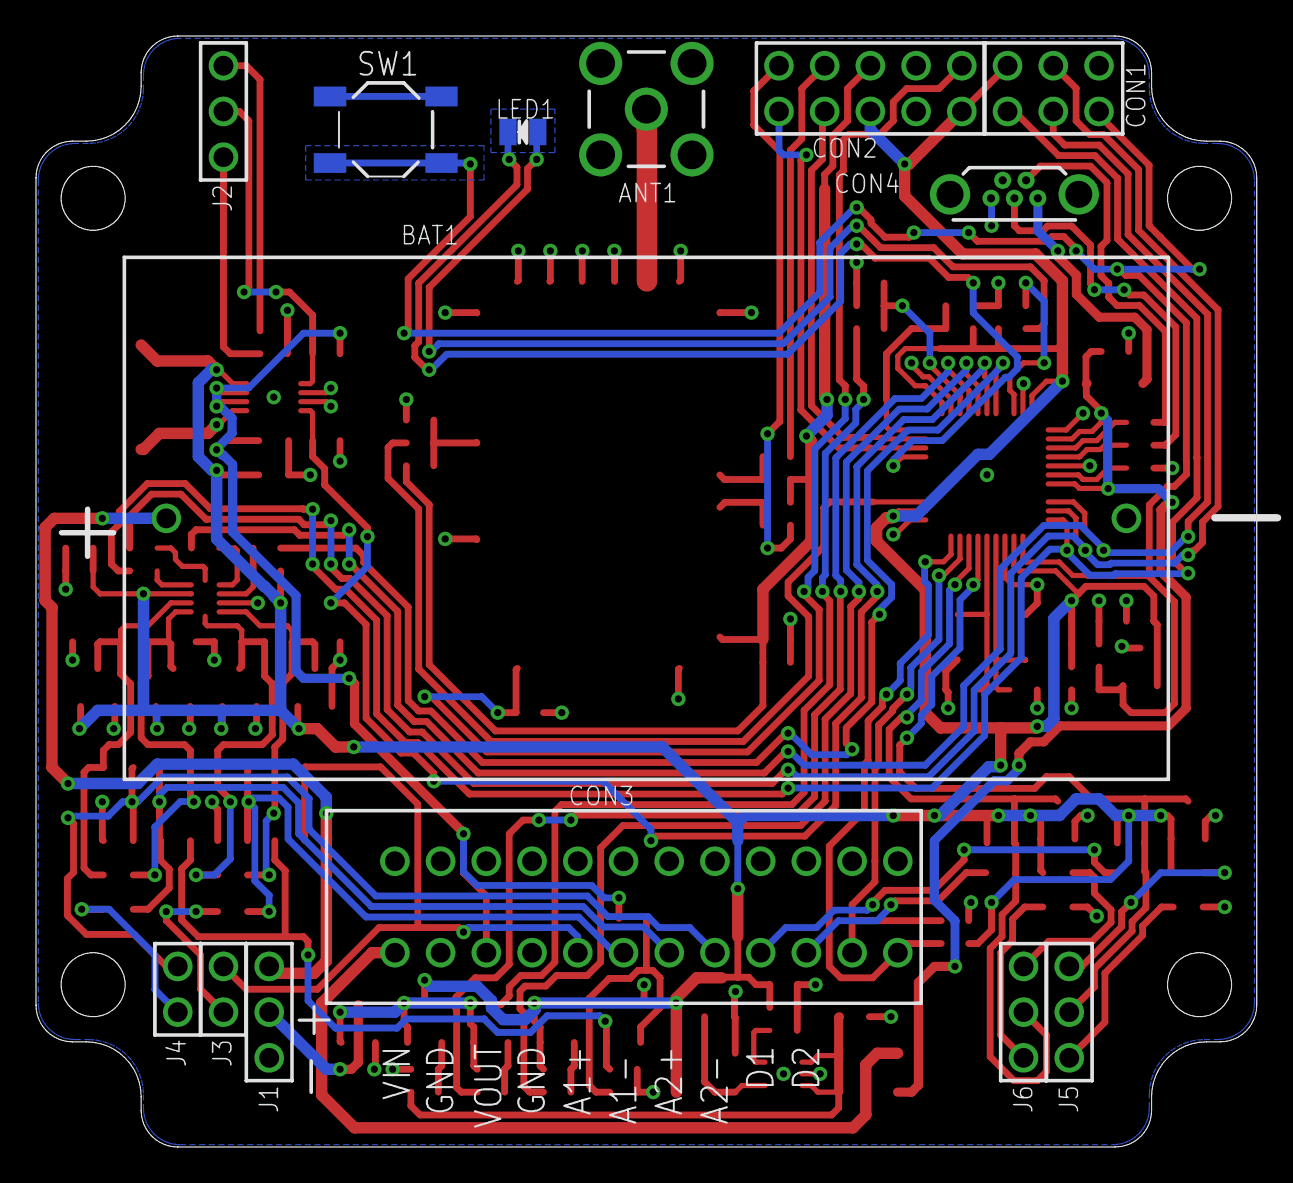
[picture p12: board outdoor-811/eagle/ad/ad.brd from below]

Board: 2 copper layers, 67.8 x 61.7 mm, 121 parts (14 on the bottom side), 77 nets.
